maxsimmonds1337/EBIKE/KiCAD_Ebike_Controller/Download_STP_7461383_rev1.stp

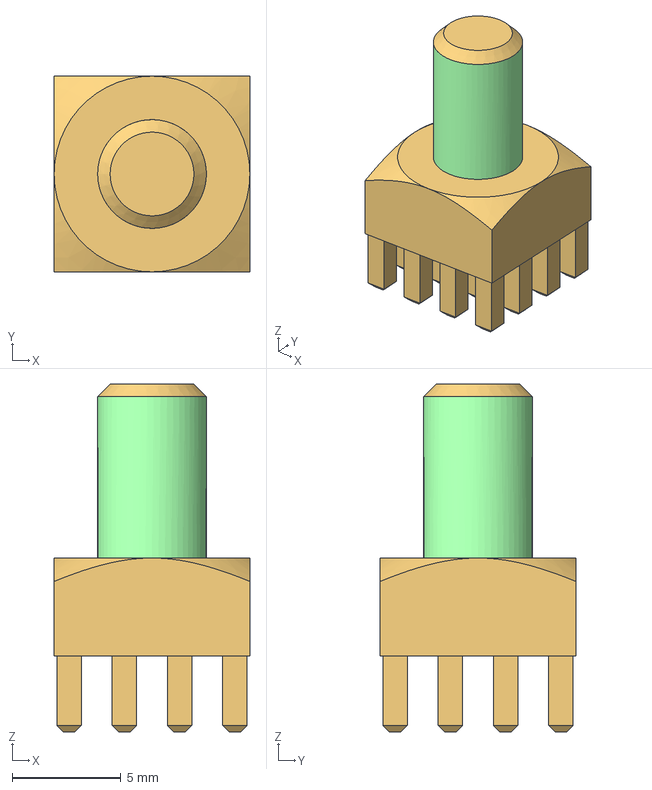
[picture p1: CAD file, 2021-01-02]
KiCAD_Ebike_Controller/Download_STP_7461383_rev1.stp
9.00 x 9.00 x 16.0 mm
