maxsimmonds1337/EBIKE/KiCAD_Ebike_Controller/Enclosure/box2.SLDPRT

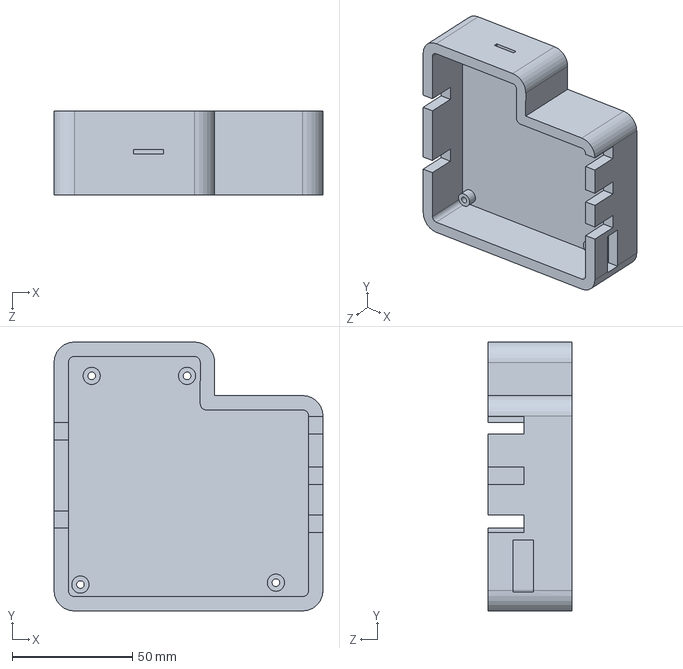
[picture p2: CAD file, 2021-09-16]
KiCAD_Ebike_Controller/Enclosure/box2.SLDPRT
112.0 x 112.0 x 35.0 mm
