maxsimmonds1337/EBIKE/KiCAD_Ebike_Controller/Enclosure/throttlebody.SLDPRT

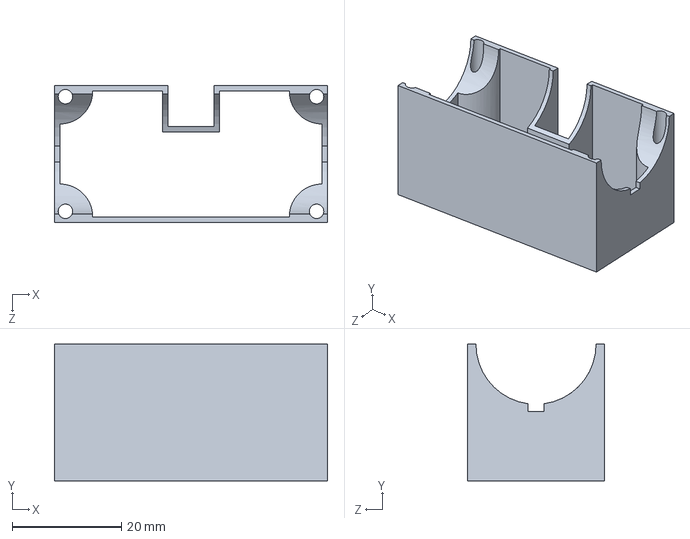
[picture p4: CAD file, 2021-09-16]
KiCAD_Ebike_Controller/Enclosure/throttlebody.SLDPRT
50.0 x 25.0 x 25.0 mm
