maxsimmonds1337/EBIKE/KiCAD_Ebike_Controller/Enclosure/throttlebodyTOP.SLDPRT

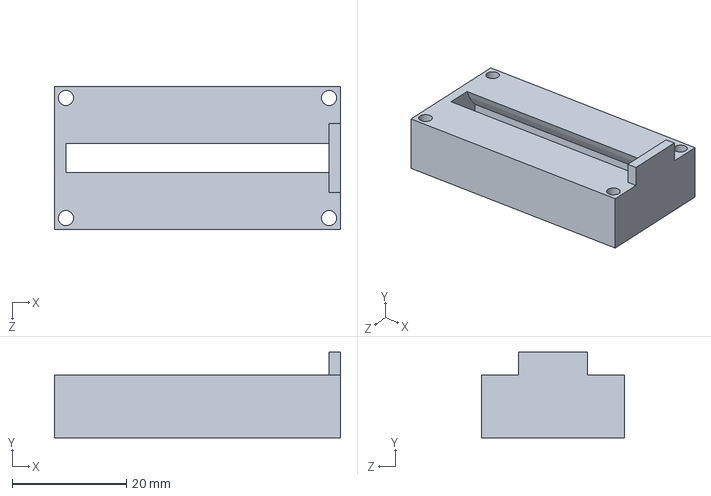
[picture p5: CAD file, 2021-09-16]
KiCAD_Ebike_Controller/Enclosure/throttlebodyTOP.SLDPRT
50.0 x 15.0 x 25.0 mm
