maxsimmonds1337/EBIKE/KiCAD_Ebike_Controller/Enclosure/SpeedoHolder.SLDPRT

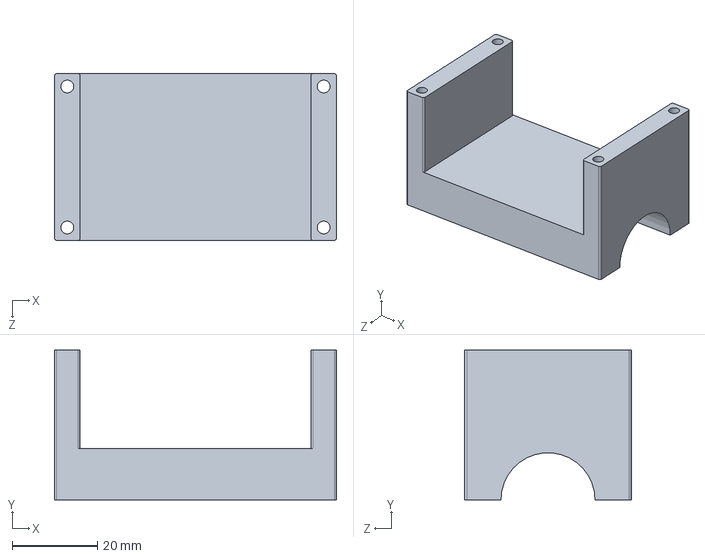
[picture p6: CAD file, 2021-09-16]
KiCAD_Ebike_Controller/Enclosure/SpeedoHolder.SLDPRT
66.0 x 35.0 x 39.0 mm
