maxsimmonds1337/EBIKE/KiCAD_Ebike_Controller/Enclosure/lid.SLDPRT

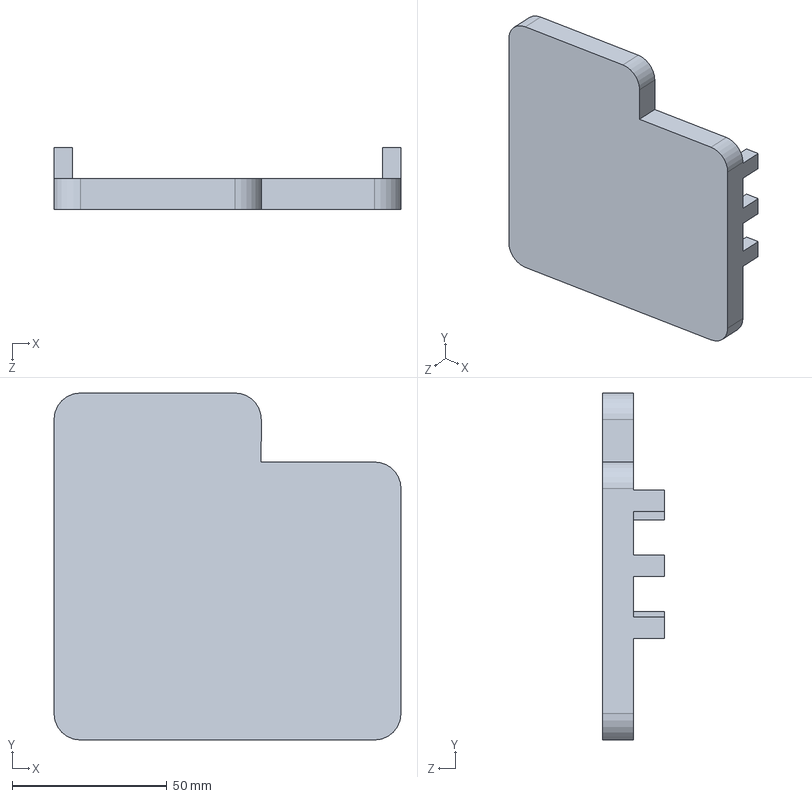
[picture p7: CAD file, 2021-09-16]
KiCAD_Ebike_Controller/Enclosure/lid.SLDPRT
112.0 x 112.0 x 20.0 mm
