maxsimmonds1337/EBIKE/(list of files, cad)

Other CAD files:
KiCAD_Ebike_Controller/Enclosure/SpeedoHolder.STL
KiCAD_Ebike_Controller/Enclosure/box.STL
KiCAD_Ebike_Controller/Enclosure/lid.STL
KiCAD_Ebike_Controller/Enclosure/throttlebody.STL
KiCAD_Ebike_Controller/Enclosure/throttlebodyTOP.STL
