maxsimmonds1337/EBIKE/(threads)

Thread 2 (2021-01-21):

C18 needs to be 470nF, not 0.47nF

maxsimmonds1337, 2021-01-21:
C18 needs to be 470nF, not 0.47nF - replace in the schematic. I have ordered a 470n instead.

Thread 10 (2021-02-06):

C30 Foot print wrong

maxsimmonds1337, 2021-02-06:
C30 Foot print wrong

Thread 12 (2021-02-06):

Low pass filter too long for hall effect

maxsimmonds1337, 2021-02-06:
Low pass filter too long for hall effect - change 100k to 23k (reuse buck resistor)

Thread 8 (2021-02-06):

D1-D6 footprint's too large

maxsimmonds1337, 2021-02-06:
D1-D6 footprint's too large

Thread 9 (2021-02-06):

U3 (I2C expander) footprint wrong

maxsimmonds1337, 2021-02-06:
U3 (I2C expander) footprint wrong

Thread 14 (2021-02-11):

I2C address

maxsimmonds1337, 2021-02-11:
address is 0x40 not 0x20, text needs changing on schematic

maxsimmonds1337, 2021-02-12:
This is actually correct, so closing

Closed 2021-02-12.

Thread 15 (2021-02-13):

Press fit connectors too large

maxsimmonds1337, 2021-02-13:
The press fit connectors do not press in to the connectors, upon review, it seems the hole diameter should be 1.45mm, currently it is 1.6mm.

Thread 16 (2021-02-19):

Swap pwm and direction lines

maxsimmonds1337, 2021-02-19:
Swap pwm and direction lines, this is because the io for the pwm does not have a timer output channel needed for the pwm.

Thread 17 (2021-02-20):

wrong resistor for buck converter

maxsimmonds1337, 2021-02-20:
swap the 23.7K resistor for a 16.2k
