maxsimmonds1337/EBIKE/KiCAD_Ebike_Controller/Ebike_Controller.pdf

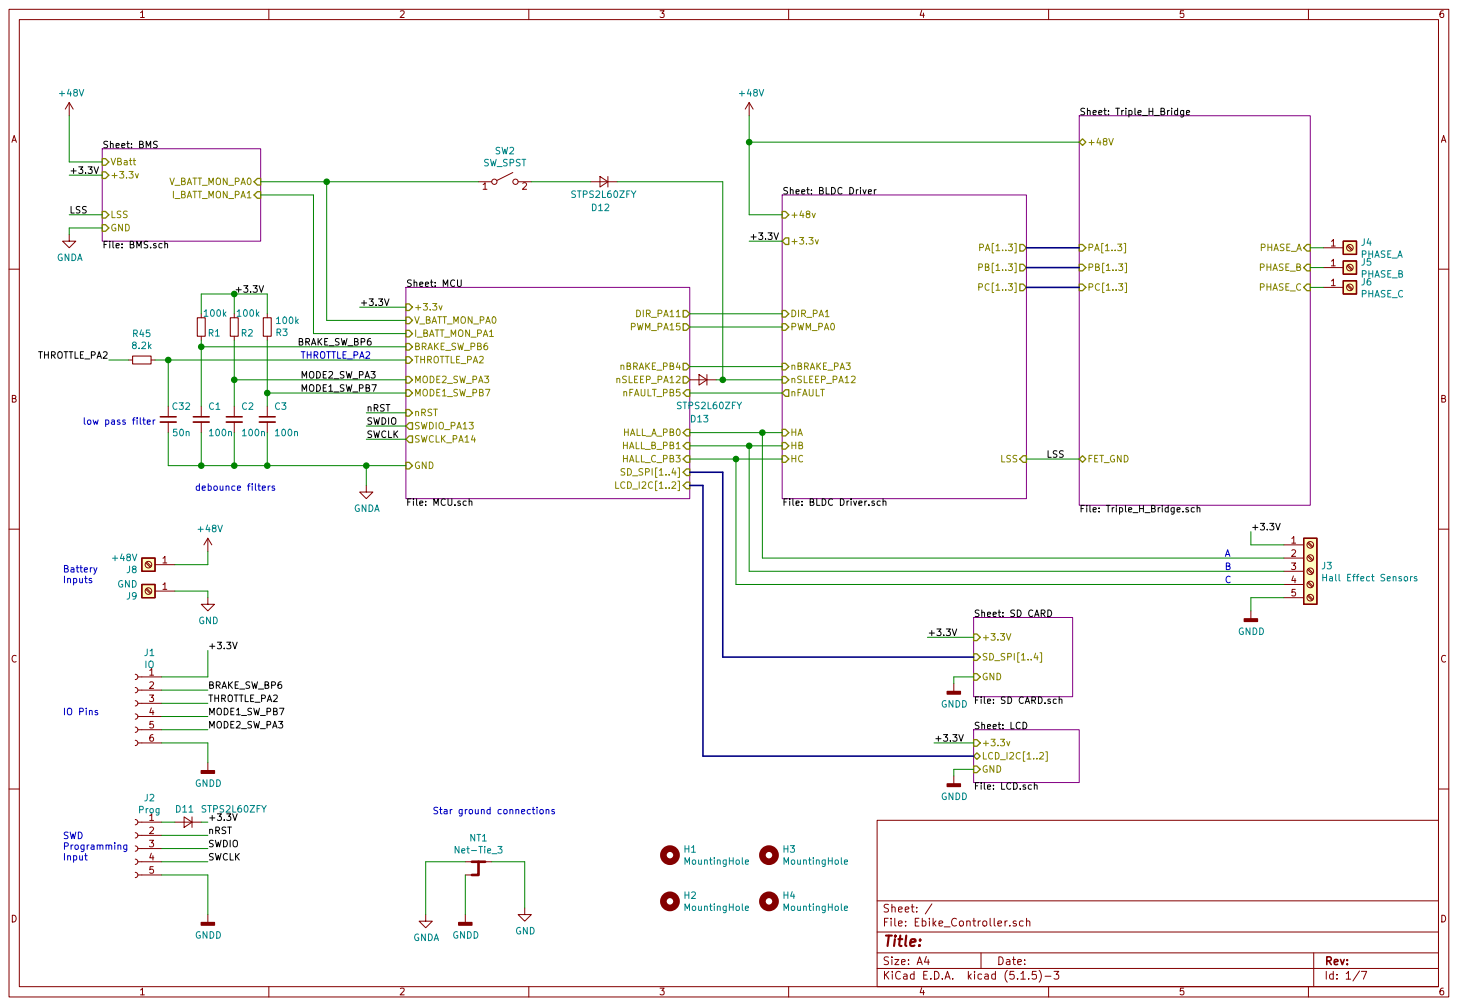
[picture p8: page 1]

PC[1..3] Sheet: BLDC Driver File: BLDC Driver.sch HC

File: SD CARD.sch GND

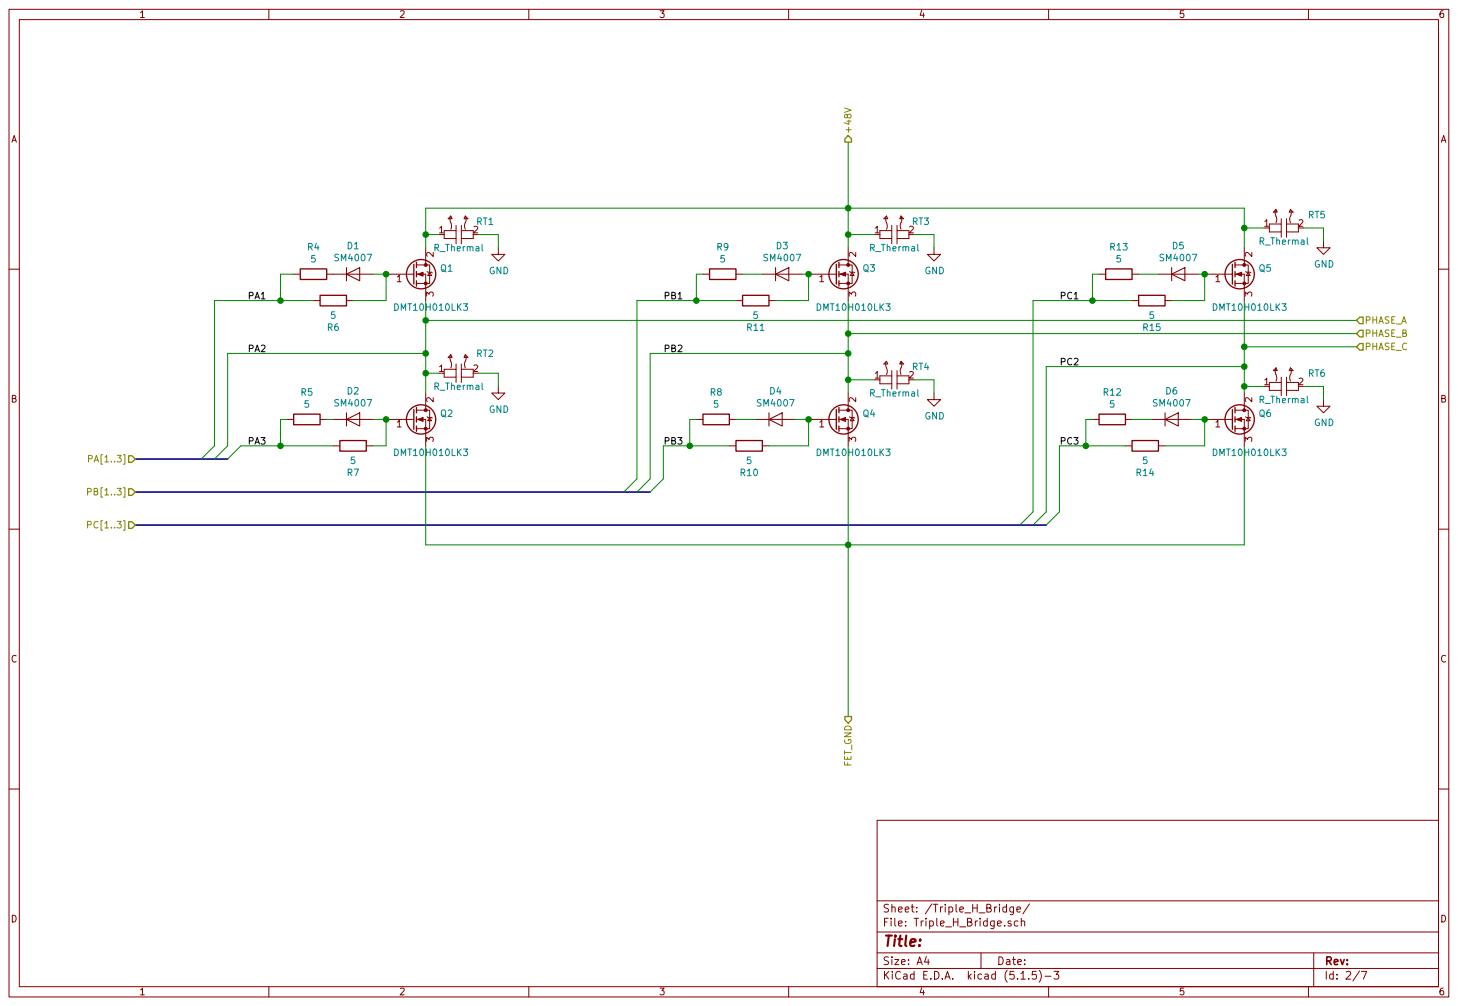
[picture p9: page 2]

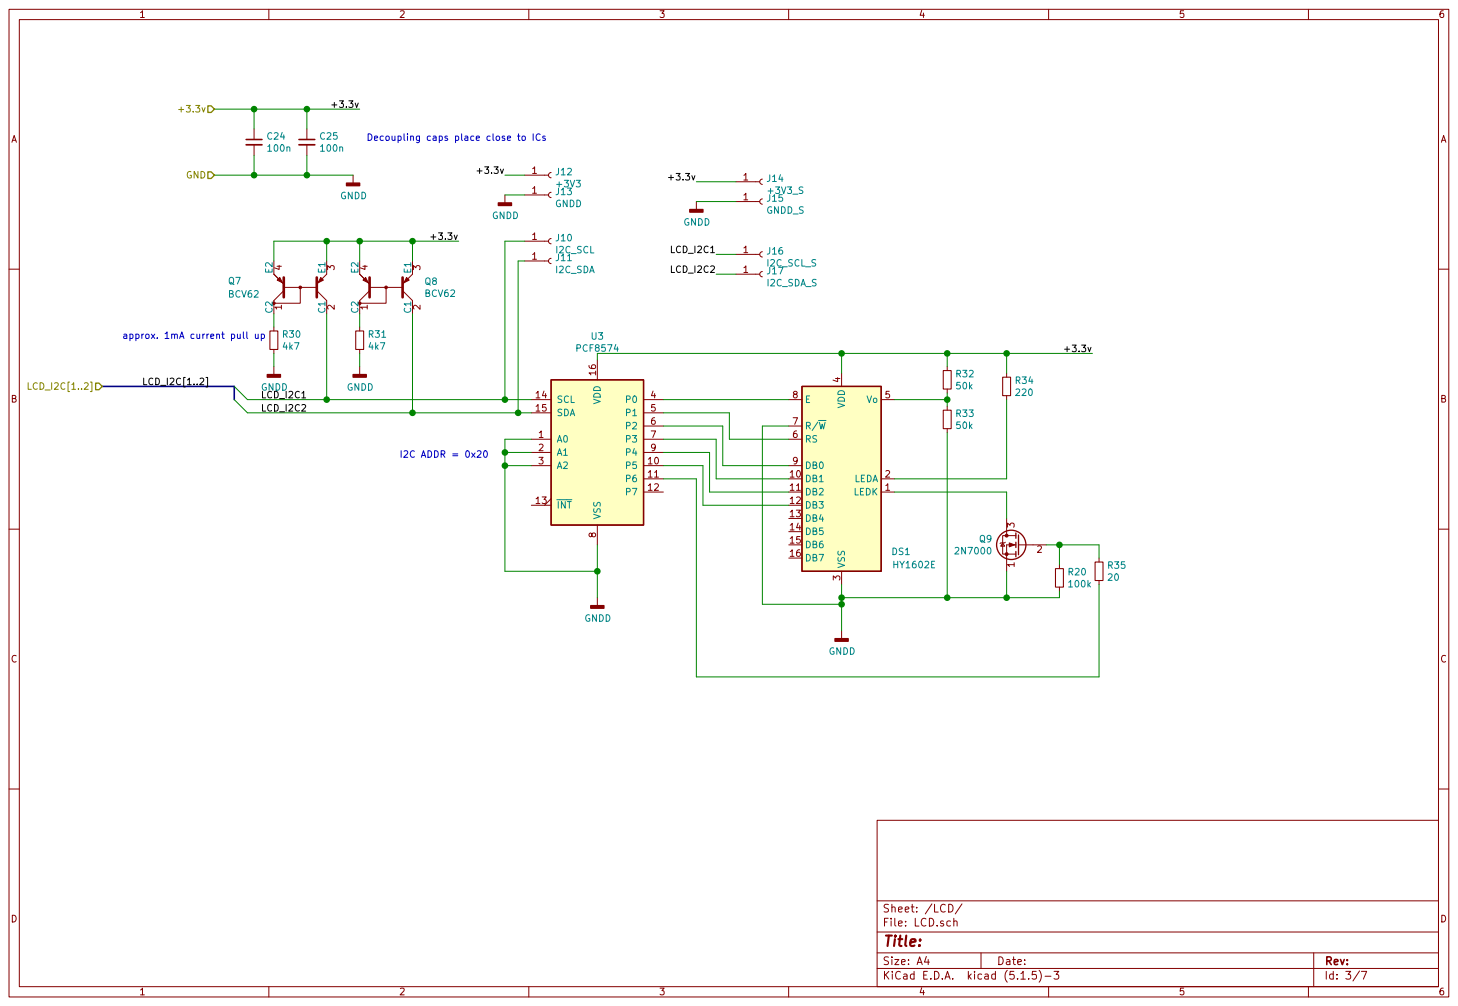
[picture p10: page 3]

I2C ADDR = 0x20 Decoupling caps place close to ICs

approx. 1mA current pull up

Id: 3/7 Title: File: LCD.sch Sheet: /LCD/

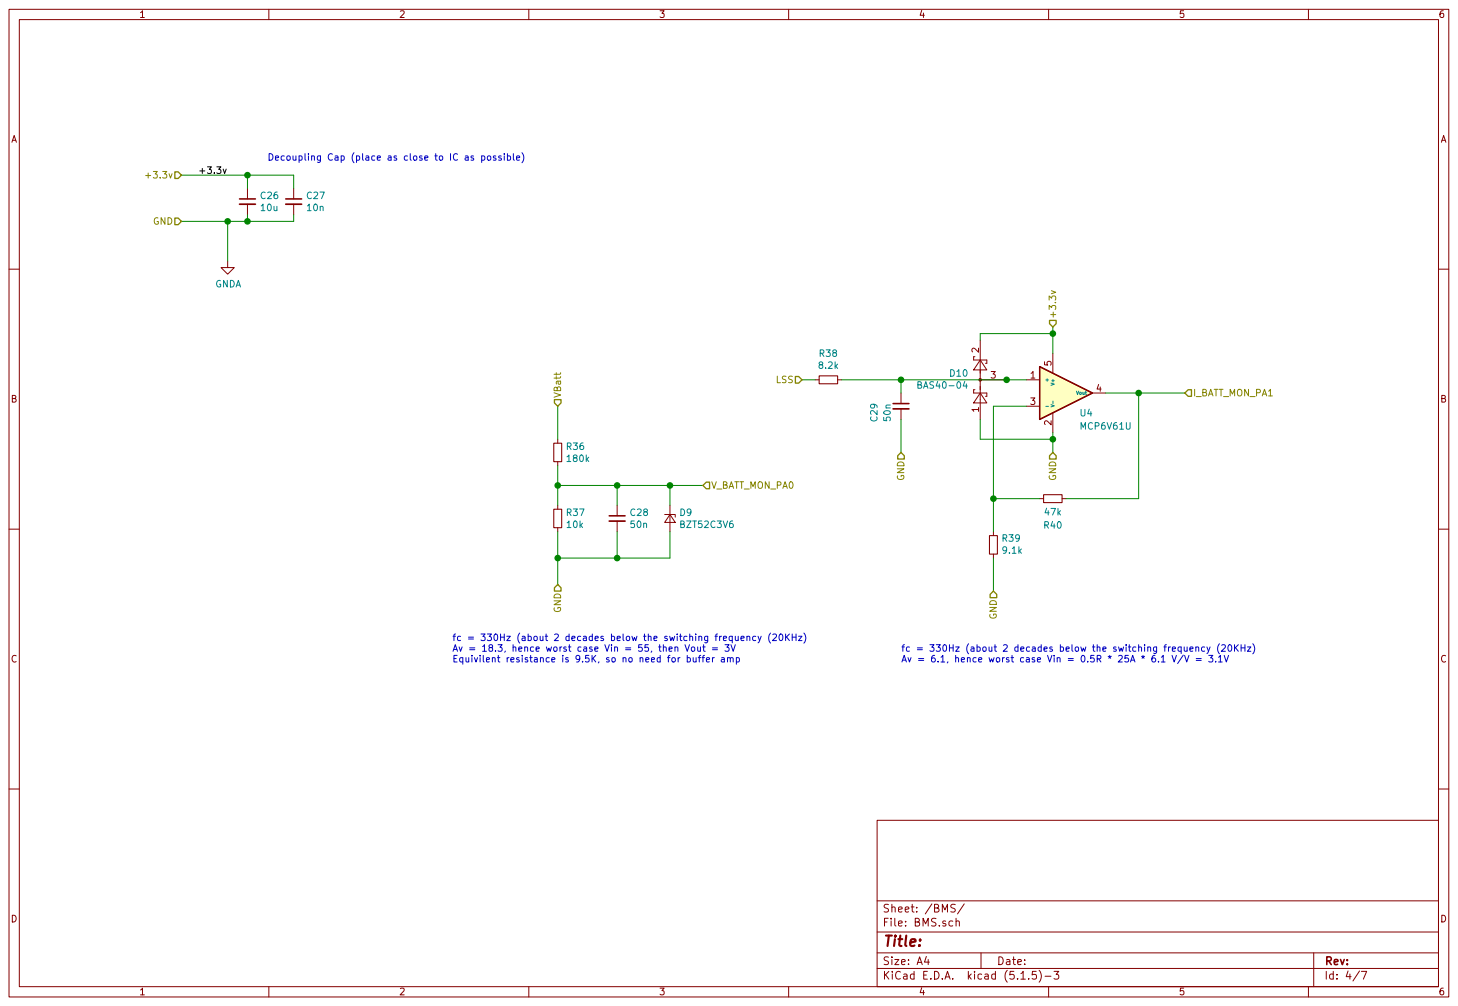
[picture p11: page 4]

Decoupling Cap (place as close to IC as possible)

Id: 4/7 Title: File: BMS.sch Sheet: /BMS/ C29 50n D9BZT52C3V6 GNDA

fc = 330Hz (about 2 decades below the switching frequency (20KHz) Av = 18.3, hence worst case Vin = 55, then Vout = 3V

fc = 330Hz (about 2 decades below the switching frequency (20KHz) Av = 6.1, hence worst case Vin = 0.5R * 25A * 6.1 V/V = 3.1V

Equivilent resistance is 9.5K, so no need for buffer amp

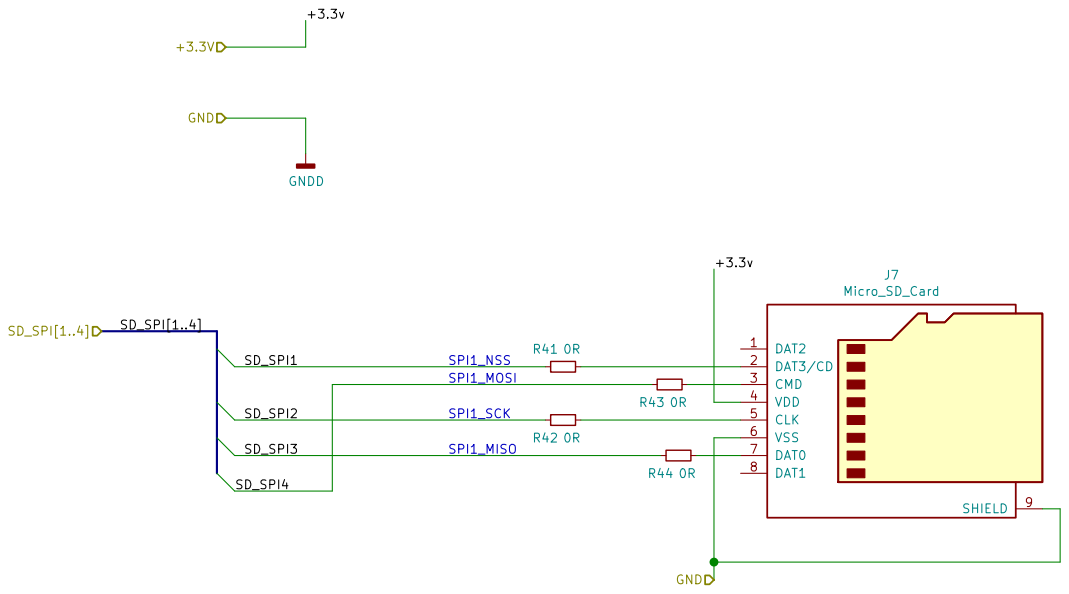
[picture p12: page 5]

Id: 5/7 Title: File: SD CARD.sch Sheet: /SD CARD/

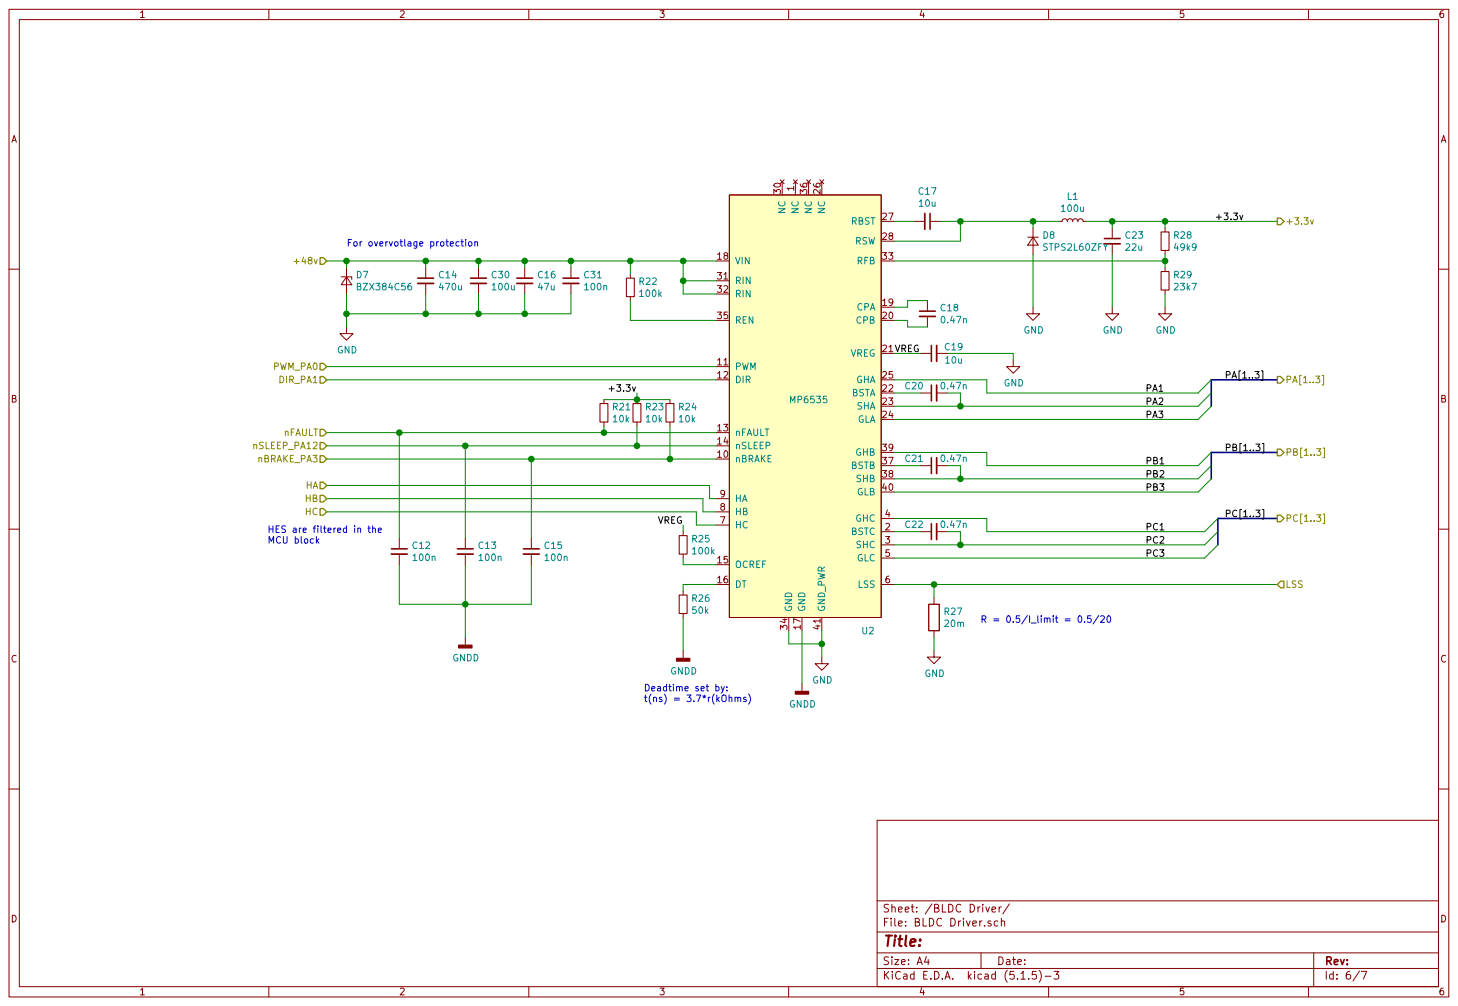
[picture p13: page 6]

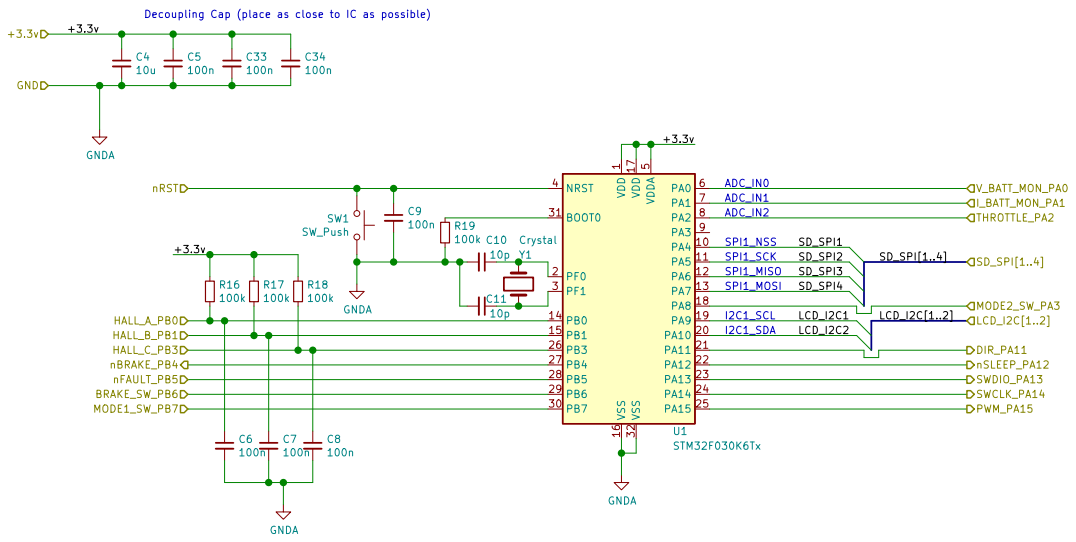
[picture p14: page 7]

ADC_IN0 Decoupling Cap (place as close to IC as possible)

Id: 7/7 Title: File: MCU.sch Sheet: /MCU/ C8
