maxsimmonds1337/EBIKE/KiCAD_Ebike_Controller/Ebike_Controller.kicad_pcb

## KiCad design KiCAD_Ebike_Controller/Ebike_Controller.kicad_pcb (2021-09-16)

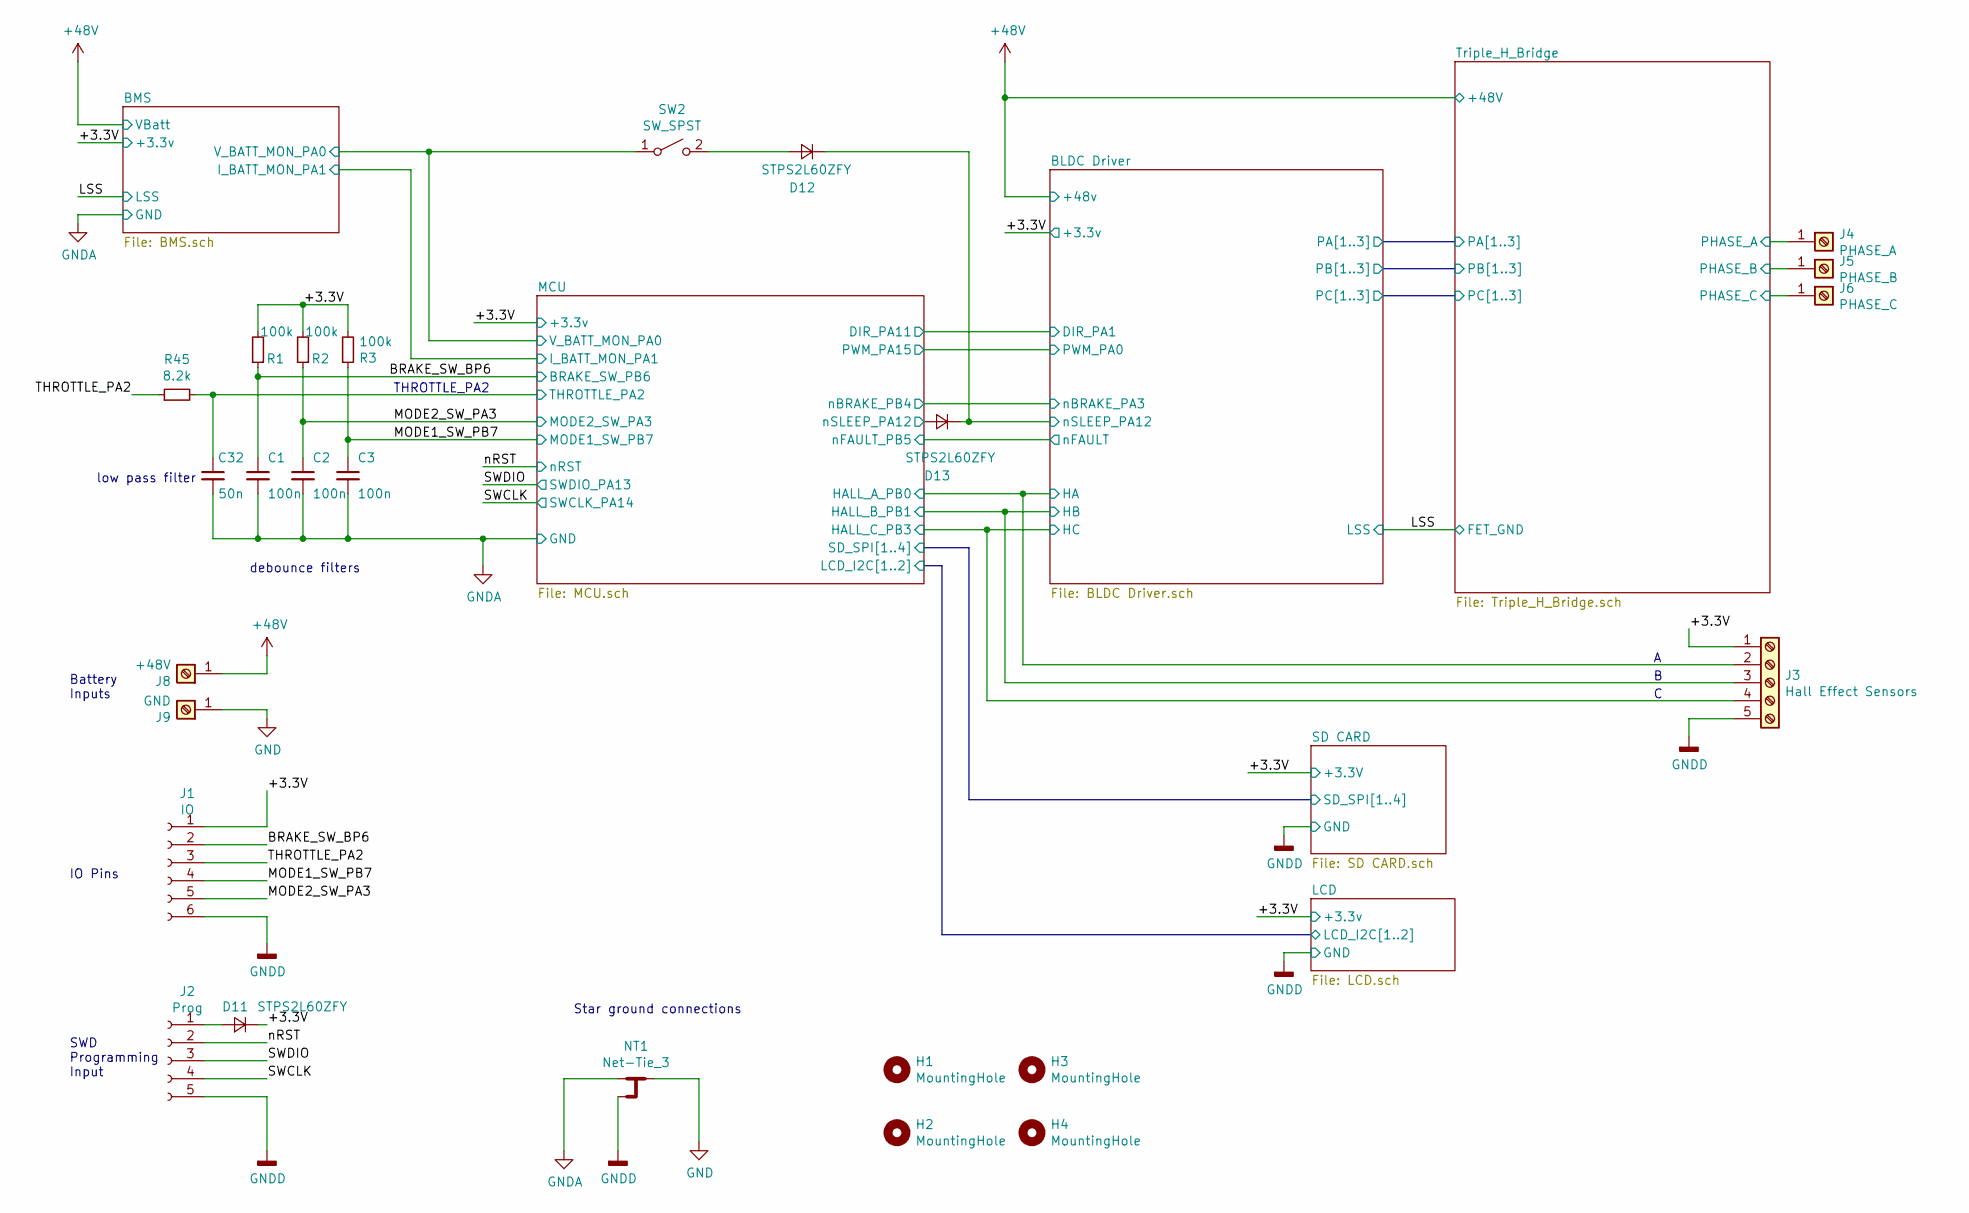
[picture p15: schematic Ebike_Controller.sch]

Parts:
C1, C2, C3: 100n; C_0805_2012Metric_Pad1.15x1.40mm_HandSolder
C32: 50n; C_0805_2012Metric_Pad1.15x1.40mm_HandSolder
D11, D12, D13: STPS2L60ZFY; D_SOD-123
H1, H2: MountingHole; MountingHole_3.2mm_M3
H3, H4: MountingHole; MountingHole_3.2mm_M3_DIN965
J1: IO; PinHeader_1x06_P2.54mm_Vertical
J2: Prog; PinHeader_1x05_P2.54mm_Vertical
J3: Hall Effect Sensors; PhoenixContact_MC_1,5_5-G-3.81_1x05_P3.81mm_Horizontal
J4: PHASE_A; 180A_screw_terminal_7461383
J5: PHASE_B; 180A_screw_terminal_7461383
J6: PHASE_C; 180A_screw_terminal_7461383
J8: +48V; 180A_screw_terminal_7461383
J9: GND; 180A_screw_terminal_7461383
NT1: Net-Tie_3; NetTie-3_THT_Pad1.0mm
R1, R2, R3: 100k; R_0805_2012Metric_Pad1.15x1.40mm_HandSolder
R45: 8.2k; R_0805_2012Metric_Pad1.15x1.40mm_HandSolder
SW2: SW_SPST; PinHeader_1x02_P2.54mm_Vertical

Connections:
+48V: J8.1; also elsewhere on the board
/+3.3V: D11.1 (K), J1.1, J3.1, R1.2, R2.2, R3.2; also elsewhere on the board
/BLDC Driver/HA: J3.2; also elsewhere on the board
/BLDC Driver/nSLEEP_PA12: D12.1 (K), D13.1 (K); also elsewhere on the board
/BMS/V_BATT_MON_PA0: SW2.1 (A); also elsewhere on the board
/BRAKE_SW_BP6: C1.1, J1.2, R1.1; also elsewhere on the board
/MCU/HALL_B_PB1: J3.3; also elsewhere on the board
/MCU/HALL_C_PB3: J3.4; also elsewhere on the board
/MCU/THROTTLE_PA2: C32.1, R45.2; also elsewhere on the board
/MCU/nSLEEP_PA12: D13.2 (A); also elsewhere on the board
/MODE1_SW_PB7: C3.1, J1.4, R3.1; also elsewhere on the board
/MODE2_SW_PA3: C2.1, J1.5, R2.1; also elsewhere on the board
/SWCLK: J2.4; also elsewhere on the board
/SWDIO: J2.3; also elsewhere on the board
/THROTTLE_PA2: J1.3, R45.1
/Triple_H_Bridge/PHASE_A: J4.1; also elsewhere on the board
/Triple_H_Bridge/PHASE_B: J5.1; also elsewhere on the board
/Triple_H_Bridge/PHASE_C: J6.1; also elsewhere on the board
/nRST: J2.2; also elsewhere on the board
GND: J9.1, NT1.2; also elsewhere on the board
GNDA: C1.2, C2.2, C3.2, C32.2, NT1.1; also elsewhere on the board
GNDD: J1.6, J2.5, J3.5, NT1.3; also elsewhere on the board
unnamed: D11.2 (A), J2.1
unnamed: D12.2 (A), SW2.2 (B)

Notes on the sheet:
SWD Programming Input
debounce filters
IO Pins
Battery Inputs
THROTTLE_PA2
low pass filter
Star ground connections

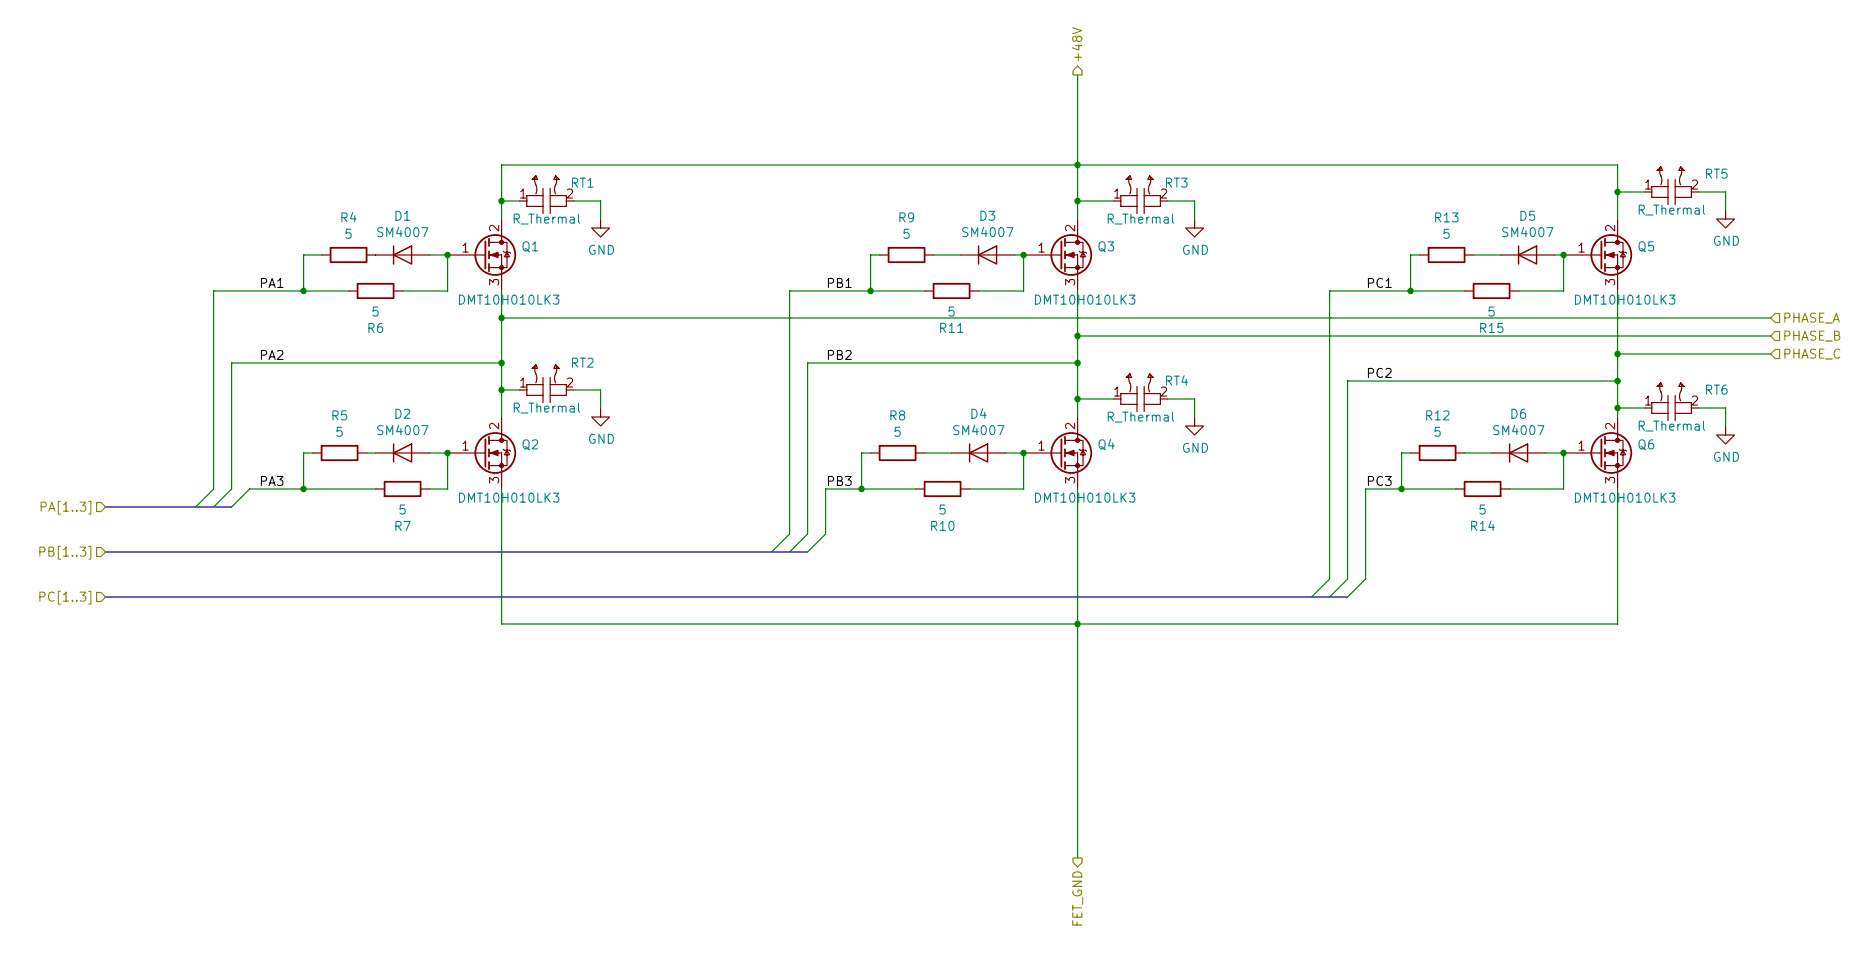
[picture p16: schematic Triple_H_Bridge.sch]

Parts:
D1, D2, D3, D4, D5, D6: SM4007; D_MELF
Q1, Q2, Q3, Q4, Q5, Q6: DMT10H010LK3; TO-252-3_TabPin2
R4, R5, R6, R7, R8, R9, R10, R11, R12, R13, R14, R15: 5; R_0805_2012Metric_Pad1.15x1.40mm_HandSolder
RT1, RT2, RT3, RT4, RT5, RT6: R_Thermal; R_1206_3216Metric_Pad1.42x1.75mm_HandSolder

Connections:
+48V: Q1.2 (D), Q3.2 (D), Q5.2 (D), RT1.1, RT3.1, RT5.1; also elsewhere on the board
/BLDC Driver/PA1: R4.2, R6.2; also elsewhere on the board
/BLDC Driver/PA3: R5.2, R7.2; also elsewhere on the board
/BLDC Driver/PB1: R9.2, R11.2; also elsewhere on the board
/BLDC Driver/PB3: R8.2, R10.2; also elsewhere on the board
/BLDC Driver/PC1: R13.2, R15.2; also elsewhere on the board
/BLDC Driver/PC3: R12.2, R14.1; also elsewhere on the board
/LSS: Q2.3 (S), Q4.3 (S), Q6.3 (S); also elsewhere on the board
/Triple_H_Bridge/PHASE_A: Q1.3 (S), Q2.2 (D), RT2.1; also elsewhere on the board
/Triple_H_Bridge/PHASE_B: Q3.3 (S), Q4.2 (D), RT4.1; also elsewhere on the board
/Triple_H_Bridge/PHASE_C: Q5.3 (S), Q6.2 (D), RT6.1; also elsewhere on the board
GND: RT1.2, RT2.2, RT3.2, RT4.2, RT5.2, RT6.2; also elsewhere on the board
unnamed: D1.1 (K), R4.1
unnamed: D1.2 (A), Q1.1 (G), R6.1
unnamed: D2.1 (K), R5.1
unnamed: D2.2 (A), Q2.1 (G), R7.1
unnamed: D3.1 (K), R9.1
unnamed: D3.2 (A), Q3.1 (G), R11.1
unnamed: D4.1 (K), R8.1
unnamed: D4.2 (A), Q4.1 (G), R10.1
unnamed: D5.1 (K), R13.1
unnamed: D5.2 (A), Q5.1 (G), R15.1
unnamed: D6.1 (K), R12.1
unnamed: D6.2 (A), Q6.1 (G), R14.2

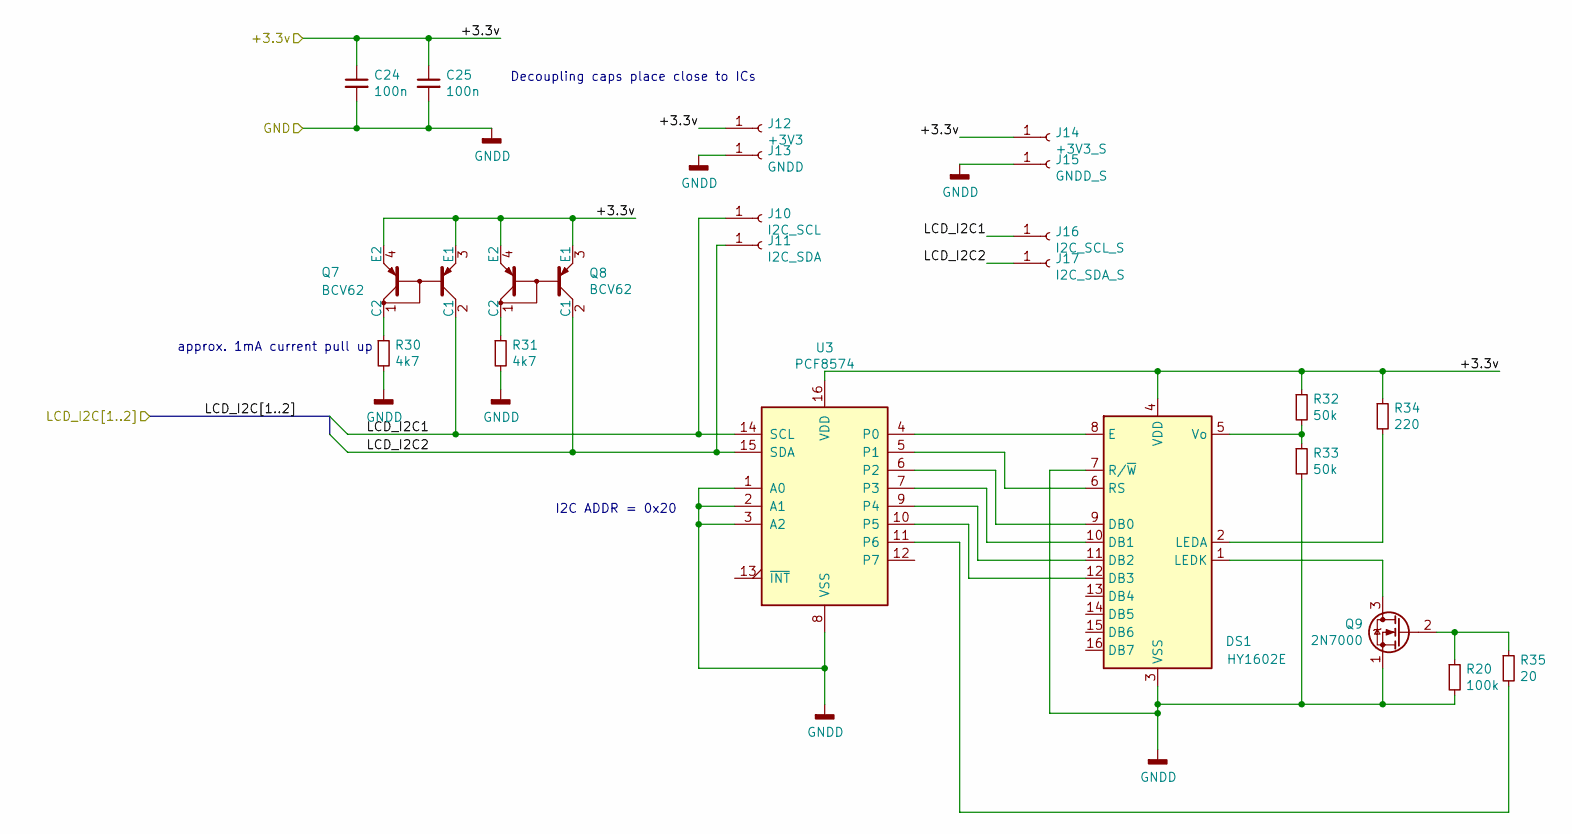
[picture p17: schematic LCD.sch]

Parts:
C24, C25: 100n; C_0805_2012Metric_Pad1.15x1.40mm_HandSolder
DS1: HY1602E
J10: I2C_SCL; PinHeader_1x01_P2.54mm_Vertical
J11: I2C_SDA; PinHeader_1x01_P2.54mm_Vertical
J12: +3V3; PinHeader_1x01_P2.54mm_Vertical
J13: GNDD; PinHeader_1x01_P2.54mm_Vertical
J14: +3V3_S; PinHeader_1x01_P2.54mm_Vertical
J15: GNDD_S; PinHeader_1x01_P2.54mm_Vertical
J16: I2C_SCL_S; PinHeader_1x01_P2.54mm_Vertical
J17: I2C_SDA_S; PinHeader_1x01_P2.54mm_Vertical
Q7, Q8: BCV62; SOT-143
Q9: 2N7000; TO-92_Inline
R20: 100k; R_0805_2012Metric_Pad1.15x1.40mm_HandSolder
R30, R31: 4k7; R_0805_2012Metric_Pad1.15x1.40mm_HandSolder
R32, R33: 50k; R_0805_2012Metric_Pad1.15x1.40mm_HandSolder
R34: 220; R_0805_2012Metric_Pad1.15x1.40mm_HandSolder
R35: 20; R_0805_2012Metric_Pad1.15x1.40mm_HandSolder
U3: PCF8574; SOIC-18W_7.5x11.6mm_P1.27mm

Connections:
/+3.3V: C24.1, C25.1, DS1.4 (VDD), J12.1, J14.1, Q7.3 (E1), Q7.4 (E2), Q8.3 (E1), Q8.4 (E2), R32.1, R34.1, U3.16 (VDD); also elsewhere on the board
/LCD/LCD_I2C1: J10.1, J16.1, Q7.2 (C1), U3.14 (SCL); also elsewhere on the board
/LCD/LCD_I2C2: J11.1, J17.1, Q8.2 (C1), U3.15 (SDA); also elsewhere on the board
GNDD: C24.2, C25.2, DS1.3 (VSS), DS1.7 (R/~W), J13.1, J15.1, Q9.1 (S), R20.2, R30.2, R31.2, R33.2, U3.1 (A0), U3.2 (A1), U3.3 (A2), U3.8 (VSS); also elsewhere on the board
unnamed: DS1.1 (LEDK), Q9.3 (D)
unnamed: DS1.2 (LEDA), R34.2
unnamed: DS1.5 (Vo), R32.2, R33.1
unnamed: DS1.6 (RS), U3.5 (P1)
unnamed: DS1.8 (E), U3.4 (P0)
unnamed: DS1.9 (DB0), U3.6 (P2)
unnamed: DS1.10 (DB1), U3.7 (P3)
unnamed: DS1.11 (DB2), U3.9 (P4)
unnamed: DS1.12 (DB3), U3.10 (P5)
unnamed: Q7.1 (C2), R30.1
unnamed: Q8.1 (C2), R31.1
unnamed: Q9.2 (G), R20.1, R35.1
unnamed: R35.2, U3.11 (P6)

Notes on the sheet:
I2C ADDR = 0x20
Decoupling caps place close to ICs
approx. 1mA current pull up

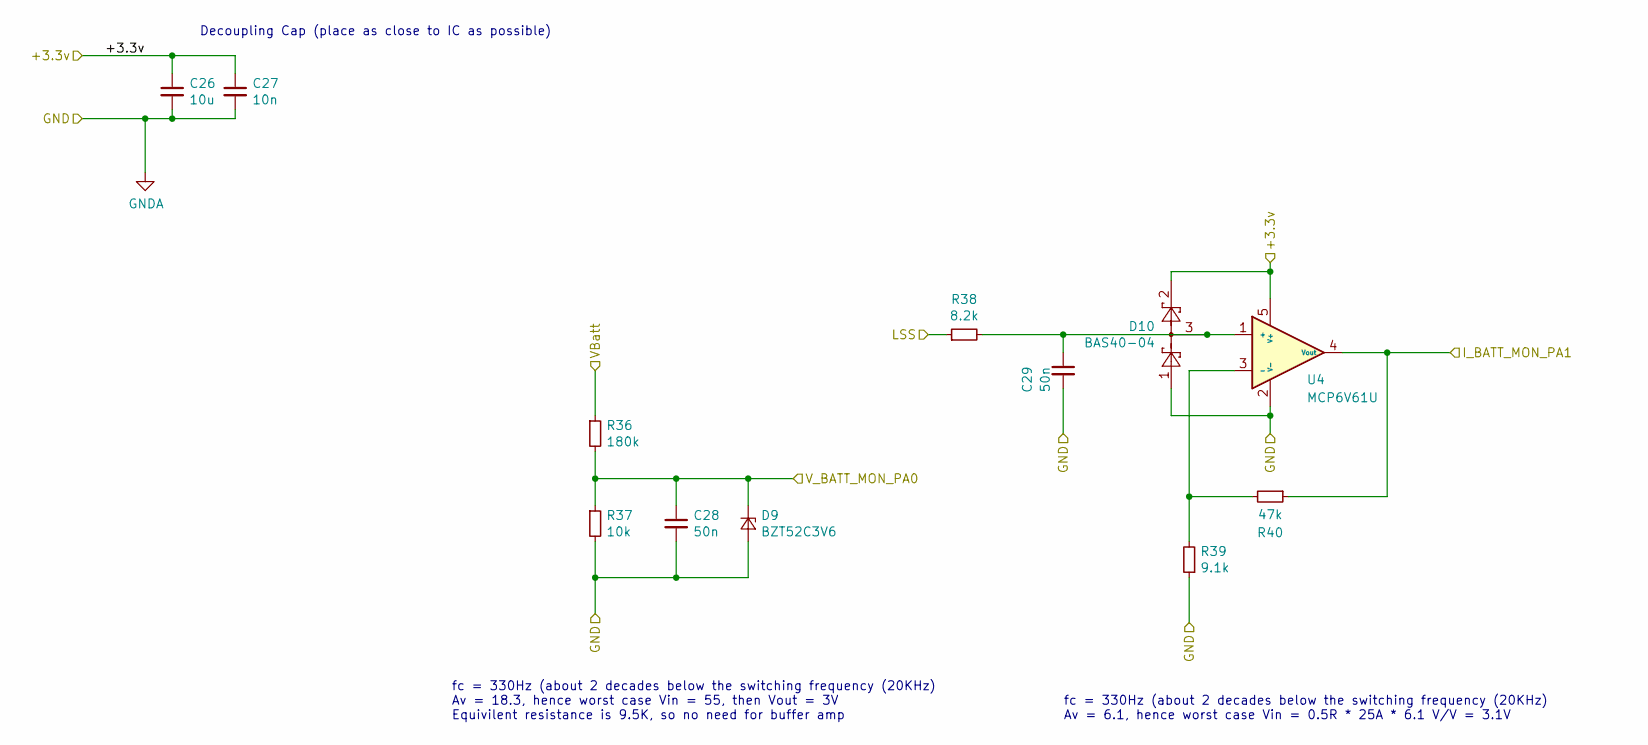
[picture p18: schematic BMS.sch]

Parts:
C26: 10u; C_0805_2012Metric
C27: 10n; C_0805_2012Metric
C28, C29: 50n; C_0805_2012Metric_Pad1.15x1.40mm_HandSolder
D9: BZT52C3V6; D_SOD-123
D10: BAS40-04; SOT-23
R36: 180k; R_0805_2012Metric_Pad1.15x1.40mm_HandSolder
R37: 10k; R_0805_2012Metric_Pad1.15x1.40mm_HandSolder
R38: 8.2k; R_0805_2012Metric_Pad1.15x1.40mm_HandSolder
R39: 9.1k; R_0805_2012Metric_Pad1.15x1.40mm_HandSolder
R40: 47k; R_0805_2012Metric_Pad1.15x1.40mm_HandSolder
U4: MCP6V61U; SOT-353_SC-70-5_Handsoldering

Connections:
+48V: R36.1; also elsewhere on the board
/+3.3V: C26.1, C27.1, D10.2, U4.5 (V+); also elsewhere on the board
/BMS/I_BATT_MON_PA1: R40.1, U4.4 (Vout); also elsewhere on the board
/BMS/V_BATT_MON_PA0: C28.1, D9.1 (K), R36.2, R37.1; also elsewhere on the board
/LSS: R38.1; also elsewhere on the board
GNDA: C26.2, C27.2, C28.2, C29.2, D9.2 (A), D10.1, R37.2, R39.1, U4.2 (V-); also elsewhere on the board
unnamed: C29.1, D10.3, R38.2, U4.1 (+)
unnamed: R39.2, R40.2, U4.3 (-)

Notes on the sheet:
fc = 330Hz (about 2 decades below the switching frequency (20KHz) Av = 6.1, hence worst case Vin = 0.5R * 25A * 6.1 V/V = 3.1V
fc = 330Hz (about 2 decades below the switching frequency (20KHz) Av = 18.3, hence worst case Vin = 55, then Vout = 3V Equivilent resistance is 9.5K, so no need for buffer amp
Decoupling Cap (place as close to IC as possible)

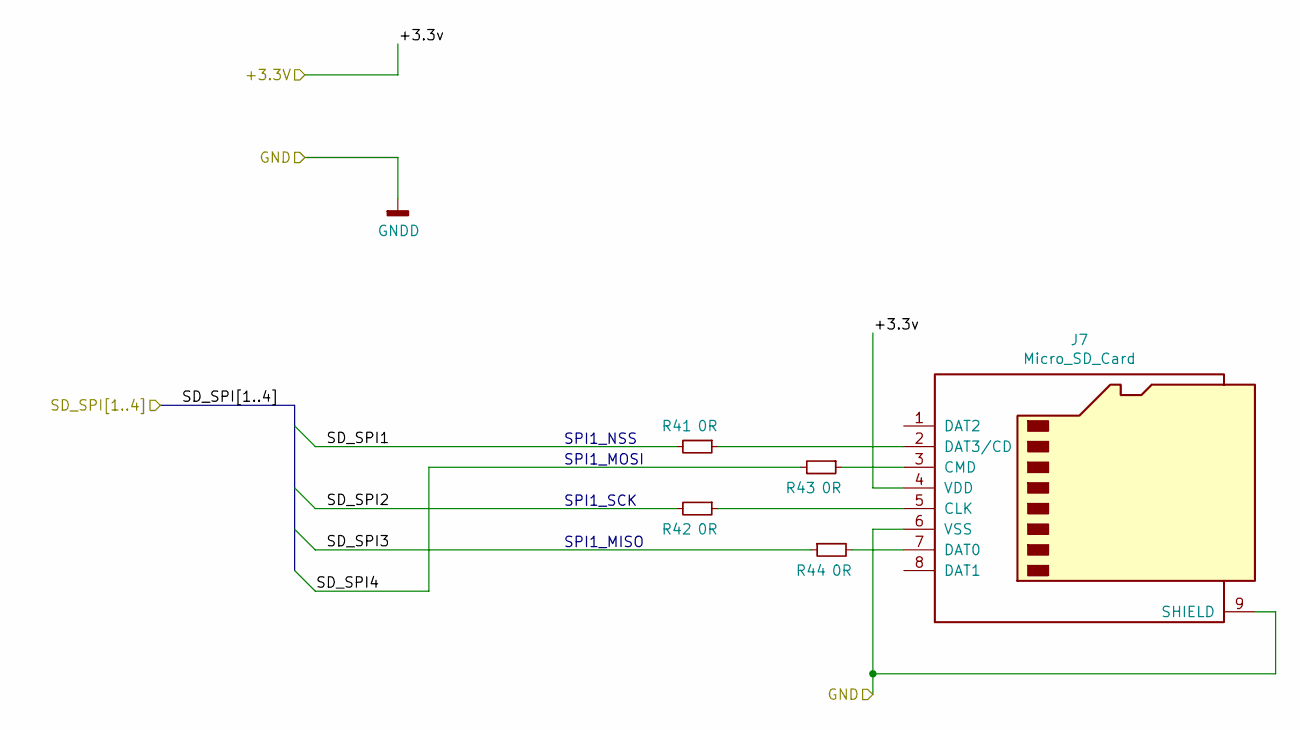
[picture p19: schematic SD CARD.sch]

Parts:
J7: Micro_SD_Card; microSD_HC_Hirose_DM3D-SF
R41, R42, R43, R44: 0R; R_0805_2012Metric_Pad1.15x1.40mm_HandSolder

Connections:
/+3.3V: J7.4 (VDD); also elsewhere on the board
/MCU/SD_SPI1: R41.2; also elsewhere on the board
/MCU/SD_SPI2: R42.2; also elsewhere on the board
/MCU/SD_SPI3: R44.1; also elsewhere on the board
/MCU/SD_SPI4: R43.2; also elsewhere on the board
GNDD: J7.6 (VSS), J7.9 (SHIELD); also elsewhere on the board
unnamed: J7.2 (DAT3/CD), R41.1
unnamed: J7.3 (CMD), R43.1
unnamed: J7.5 (CLK), R42.1
unnamed: J7.7 (DAT0), R44.2

Notes on the sheet:
SPI1_NSS
SPI1_SCK
SPI1_MISO
SPI1_MOSI

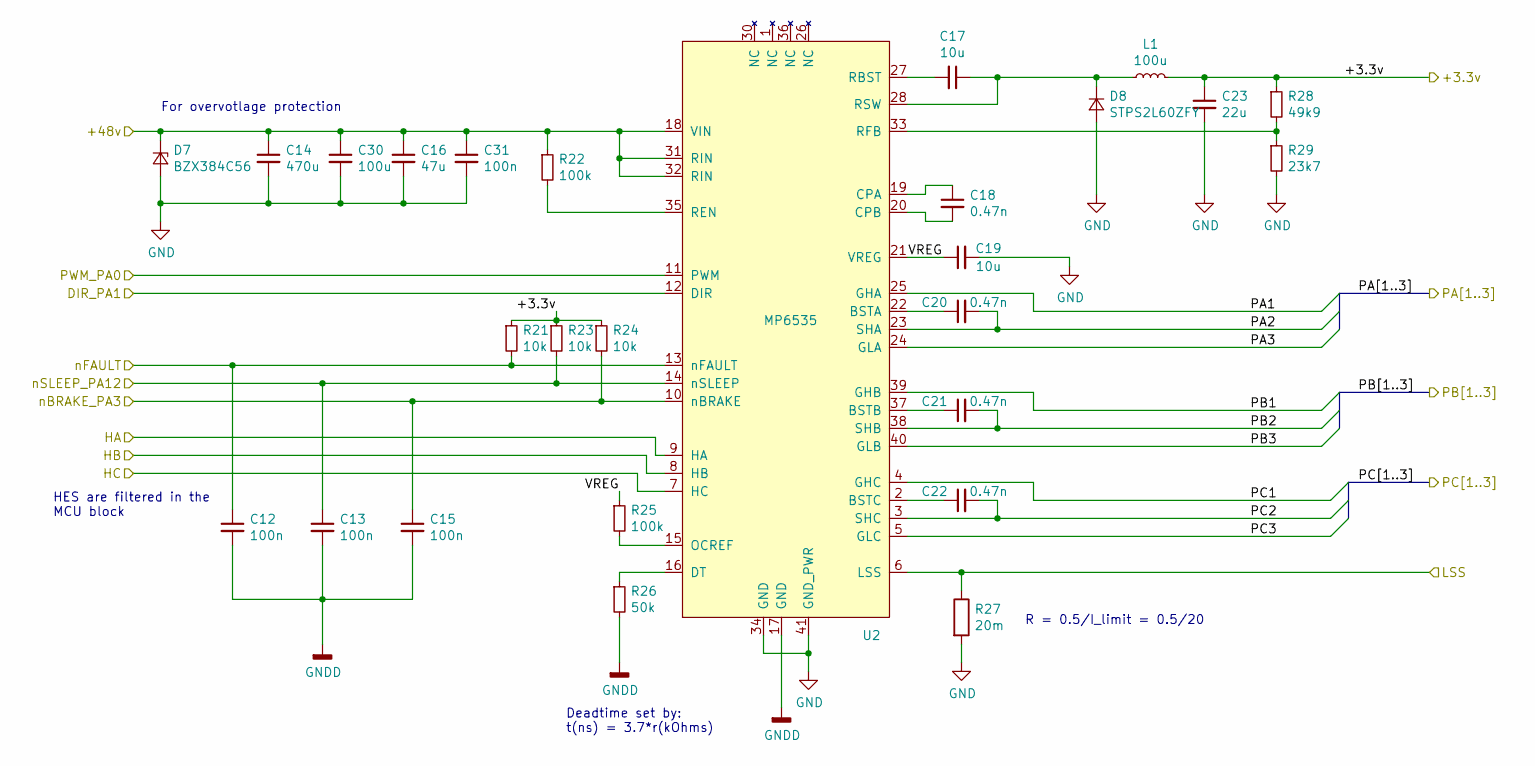
[picture p20: schematic BLDC Driver.sch]

Parts:
C12, C13, C15, C31: 100n; C_0805_2012Metric_Pad1.15x1.40mm_HandSolder
C14: 470u; CP_Elec_16x17.5
C16: 47u; CP_Elec_8x10
C17, C19: 10u; C_0805_2012Metric_Pad1.15x1.40mm_HandSolder
C18, C20, C21, C22: 0.47n; C_0805_2012Metric_Pad1.15x1.40mm_HandSolder
C23: 22u; C_0805_2012Metric_Pad1.15x1.40mm_HandSolder
C30: 100u; CP_Elec_16x17.5
D7: BZX384C56; D_SOD-323
D8: STPS2L60ZFY; D_SOD-123
L1: 100u; L_10.4x10.4_H4.8
R21, R23, R24: 10k; R_0805_2012Metric_Pad1.15x1.40mm_HandSolder
R22, R25: 100k; R_0805_2012Metric_Pad1.15x1.40mm_HandSolder
R26: 50k; R_0805_2012Metric_Pad1.15x1.40mm_HandSolder
R27: 20m; 20m_4W
R28: 49k9; R_0805_2012Metric_Pad1.15x1.40mm_HandSolder
R29: 23k7; R_0805_2012Metric_Pad1.15x1.40mm_HandSolder
U2: MP6535; QFN-40-1EP_5x5mm_P0.4mm_EP3.6x3.6mm

Connections:
+48V: C14.1, C16.1, C30.1, C31.1, D7.1 (K), R22.1, U2.18 (VIN), U2.31 (RIN), U2.32 (RIN); also elsewhere on the board
/+3.3V: C23.1, L1.2, R21.1, R23.1, R24.1, R28.1; also elsewhere on the board
/BLDC Driver/DIR_PA1: U2.12 (DIR); also elsewhere on the board
/BLDC Driver/HA: U2.9 (HA); also elsewhere on the board
/BLDC Driver/PA1: U2.25 (GHA); also elsewhere on the board
/BLDC Driver/PA3: U2.24 (GLA); also elsewhere on the board
/BLDC Driver/PB1: U2.39 (GHB); also elsewhere on the board
/BLDC Driver/PB3: U2.40 (GLB); also elsewhere on the board
/BLDC Driver/PC1: U2.4 (GHC); also elsewhere on the board
/BLDC Driver/PC3: U2.5 (GLC); also elsewhere on the board
/BLDC Driver/PWM_PA0: U2.11 (PWM); also elsewhere on the board
/BLDC Driver/VREG: C19.1, R25.1, U2.21 (VREG)
/BLDC Driver/nBRAKE_PA3: C15.1, R24.2, U2.10 (nBRAKE); also elsewhere on the board
/BLDC Driver/nFAULT: C12.1, R21.2, U2.13 (nFAULT); also elsewhere on the board
/BLDC Driver/nSLEEP_PA12: C13.1, R23.2, U2.14 (nSLEEP); also elsewhere on the board
/LSS: R27.1, U2.6 (LSS); also elsewhere on the board
/MCU/HALL_B_PB1: U2.8 (HB); also elsewhere on the board
/MCU/HALL_C_PB3: U2.7 (HC); also elsewhere on the board
/Triple_H_Bridge/PHASE_A: C20.2, U2.23 (SHA); also elsewhere on the board
/Triple_H_Bridge/PHASE_B: C21.2, U2.38 (SHB); also elsewhere on the board
/Triple_H_Bridge/PHASE_C: C22.2, U2.3 (SHC); also elsewhere on the board
GND: C14.2, C16.2, C19.2, C23.2, C30.2, C31.2, D7.2 (A), D8.2 (A), R27.2, R29.2, U2.34 (GND), U2.41 (GND_PWR); also elsewhere on the board
GNDD: C12.2, C13.2, C15.2, R26.2, U2.17 (GND); also elsewhere on the board
unnamed: C17.1, D8.1 (K), L1.1, U2.28 (RSW)
unnamed: C17.2, U2.27 (RBST)
unnamed: C18.1, U2.19 (CPA)
unnamed: C18.2, U2.20 (CPB)
unnamed: C20.1, U2.22 (BSTA)
unnamed: C21.1, U2.37 (BSTB)
unnamed: C22.1, U2.2 (BSTC)
unnamed: R22.2, U2.35 (REN)
unnamed: R25.2, U2.15 (OCREF)
unnamed: R26.1, U2.16 (DT)
unnamed: R28.2, R29.1, U2.33 (RFB)

Notes on the sheet:
For overvotlage protection
Deadtime set by: t(ns) = 3.7*r(kOhms)
R = 0.5/I_limit = 0.5/20
HES are filtered in the MCU block

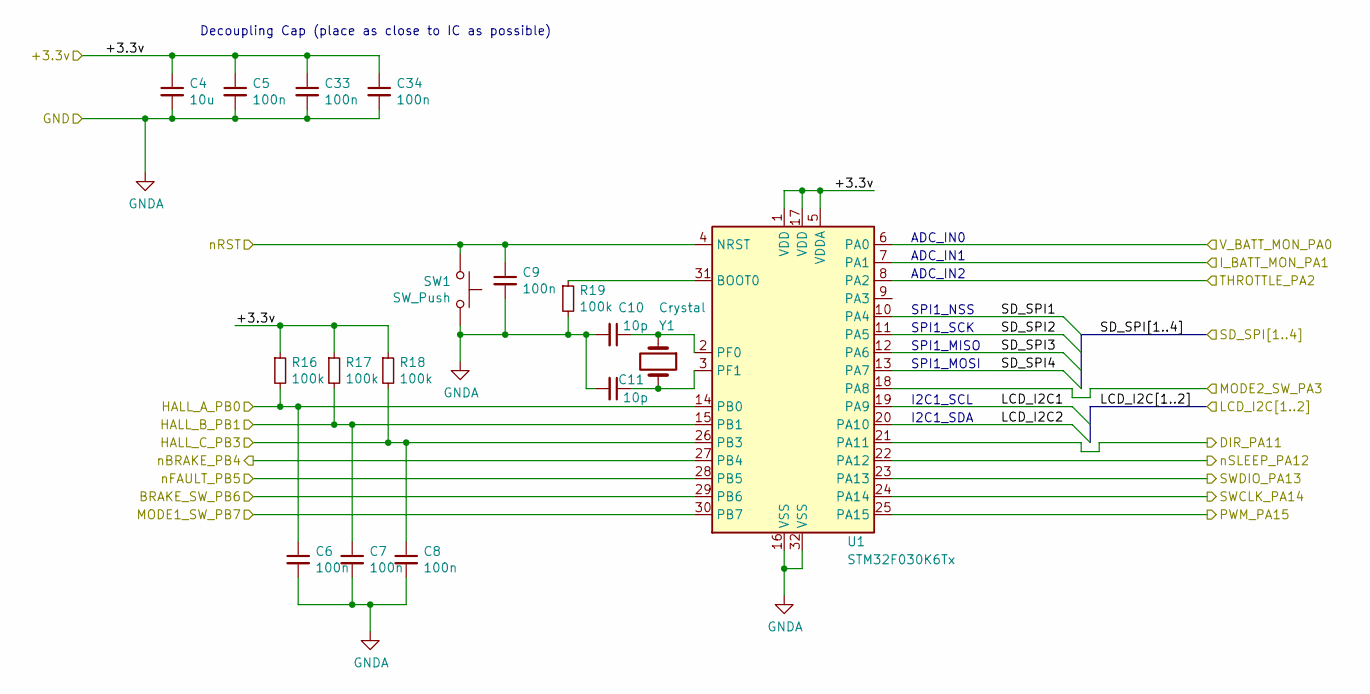
[picture p21: schematic MCU.sch]

Parts:
C4: 10u; C_0805_2012Metric_Pad1.15x1.40mm_HandSolder
C5, C6, C7, C8, C33, C34: 100n; C_0805_2012Metric_Pad1.15x1.40mm_HandSolder
C9: 100n; C_0805_2012Metric
C10, C11: 10p; C_0805_2012Metric
R16, R17, R18, R19: 100k; R_0805_2012Metric_Pad1.15x1.40mm_HandSolder
SW1: SW_Push; SW_Push_1P1T_NO_6x6mm_H9.5mm
U1: STM32F030K6Tx; LQFP-32_7x7mm_P0.8mm
Y1: Crystal; Crystal_SMD_HC49-SD

Connections:
/+3.3V: C4.1, C5.1, C33.1, C34.1, R16.1, R17.1, R18.1, U1.1 (VDD), U1.5 (VDDA), U1.17 (VDD); also elsewhere on the board
/BLDC Driver/DIR_PA1: U1.21 (PA11); also elsewhere on the board
/BLDC Driver/HA: C6.1, R16.2, U1.14 (PB0); also elsewhere on the board
/BLDC Driver/PWM_PA0: U1.25 (PA15); also elsewhere on the board
/BLDC Driver/nBRAKE_PA3: U1.27 (PB4); also elsewhere on the board
/BLDC Driver/nFAULT: U1.28 (PB5); also elsewhere on the board
/BMS/I_BATT_MON_PA1: U1.7 (PA1); also elsewhere on the board
/BMS/V_BATT_MON_PA0: U1.6 (PA0); also elsewhere on the board
/BRAKE_SW_BP6: U1.29 (PB6); also elsewhere on the board
/LCD/LCD_I2C1: U1.19 (PA9); also elsewhere on the board
/LCD/LCD_I2C2: U1.20 (PA10); also elsewhere on the board
/MCU/HALL_B_PB1: C7.1, R17.2, U1.15 (PB1); also elsewhere on the board
/MCU/HALL_C_PB3: C8.1, R18.2, U1.26 (PB3); also elsewhere on the board
/MCU/SD_SPI1: U1.10 (PA4); also elsewhere on the board
/MCU/SD_SPI2: U1.11 (PA5); also elsewhere on the board
/MCU/SD_SPI3: U1.12 (PA6); also elsewhere on the board
/MCU/SD_SPI4: U1.13 (PA7); also elsewhere on the board
/MCU/THROTTLE_PA2: U1.8 (PA2); also elsewhere on the board
/MCU/nSLEEP_PA12: U1.22 (PA12); also elsewhere on the board
/MODE1_SW_PB7: U1.30 (PB7); also elsewhere on the board
/MODE2_SW_PA3: U1.18 (PA8); also elsewhere on the board
/SWCLK: U1.24 (PA14); also elsewhere on the board
/SWDIO: U1.23 (PA13); also elsewhere on the board
/nRST: C9.1, SW1.1, U1.4 (NRST); also elsewhere on the board
GNDA: C4.2, C5.2, C6.2, C7.2, C8.2, C9.2, C10.2, C11.2, C33.2, C34.2, R19.2, SW1.2, U1.16 (VSS), U1.32 (VSS); also elsewhere on the board
unnamed: C10.1, U1.2 (PF0), Y1.1
unnamed: C11.1, U1.3 (PF1), Y1.2
unnamed: R19.1, U1.31 (BOOT0)

Notes on the sheet:
ADC_IN0
ADC_IN1
SPI1_MISO
SPI1_MOSI
I2C1_SCL
I2C1_SDA
SPI1_SCK
SPI1_NSS
Decoupling Cap (place as close to IC as possible)
ADC_IN2

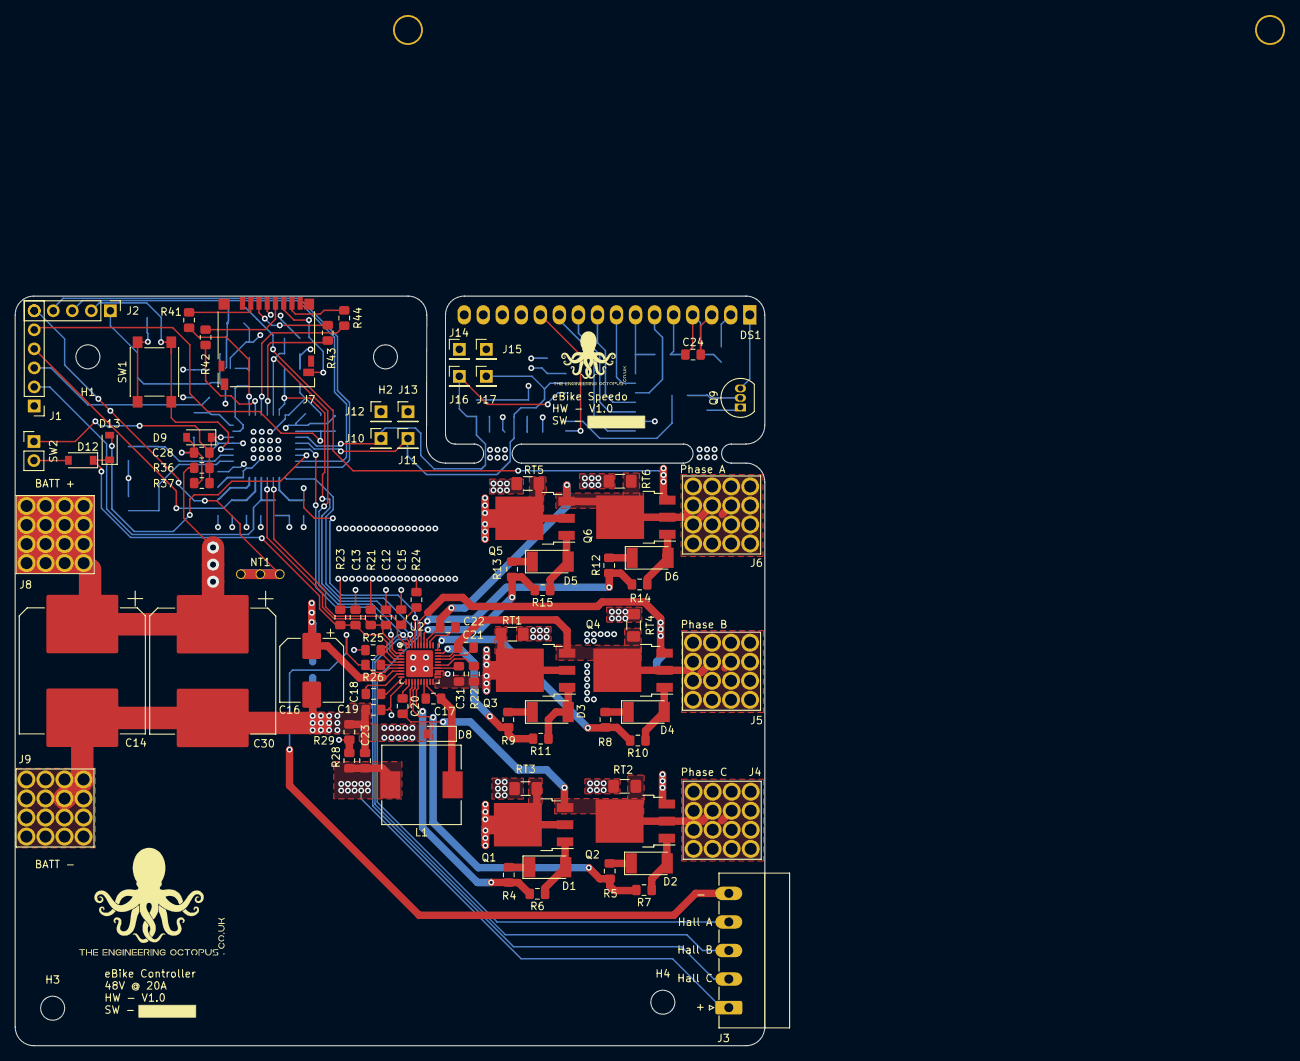
[picture p22: board Ebike_Controller.kicad_pcb from above]

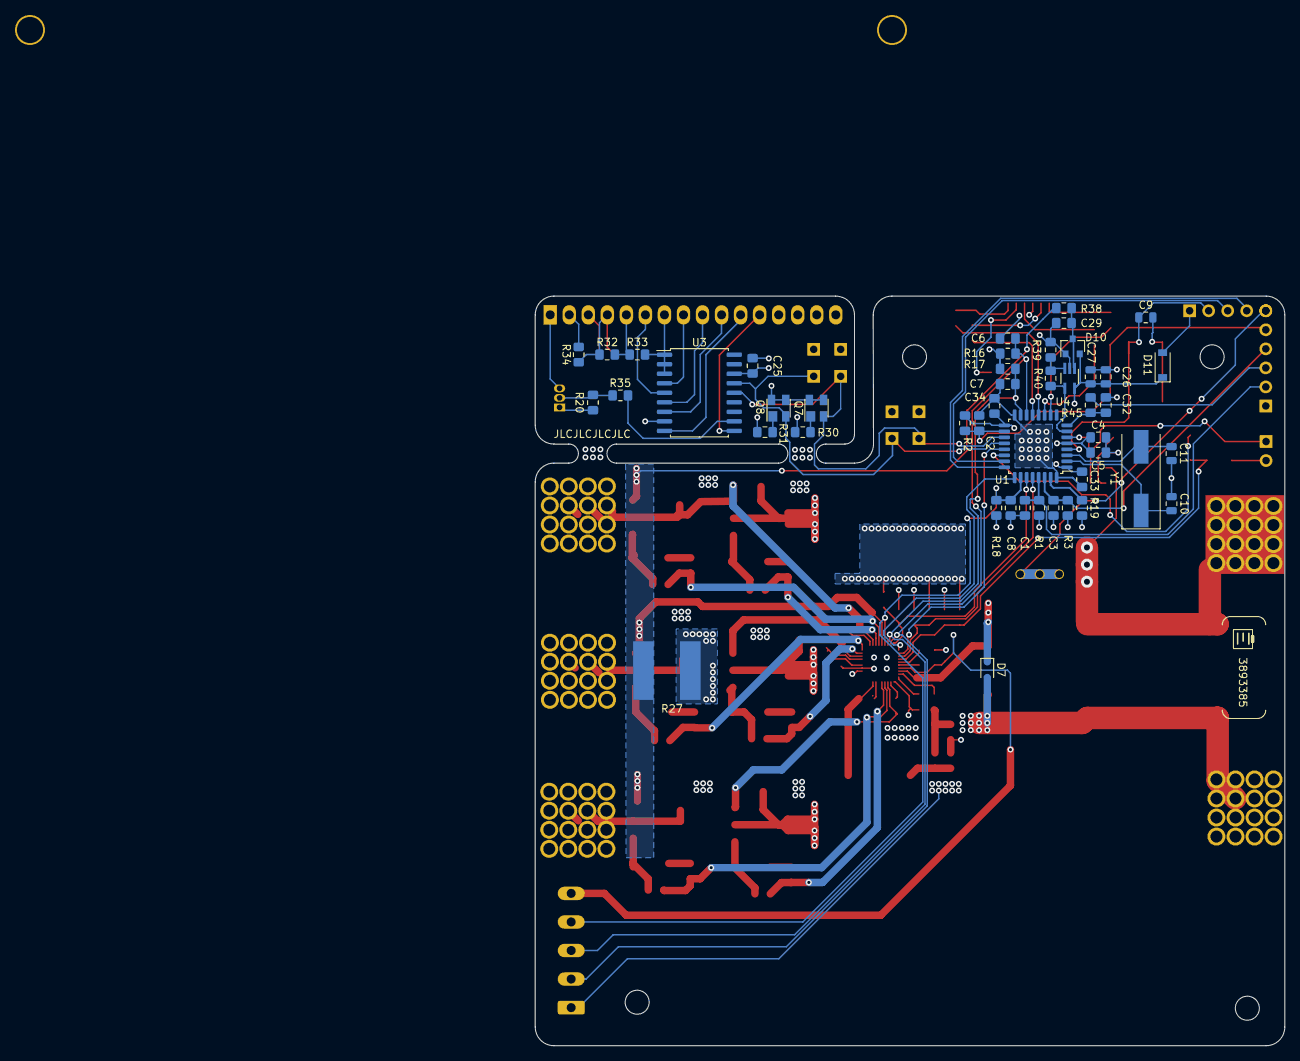
[picture p23: board Ebike_Controller.kicad_pcb from below]

Board: 4 copper layers, 100.0 x 100.0 mm, 138 parts (46 on the bottom side), 88 nets.
