maxsimmonds1337/EBIKE/(commit log)

2020-10-28 Started the schematic
    [BLDC Driver.sch, BMS.sch, Ebike_Controller.kicad_pcb, Ebike_Controller.sch, LCD.sch, MCU.sch, SD CARD.sch, Triple_H_Bridge.sch]
2020-11-03 close to being done, need to add current pull ups on i2c
    [BLDC Driver.sch, BMS.sch, Ebike_Controller.sch, LCD.sch, MCU.sch, SD CARD.sch]
2020-11-19 schem done
    [BLDC Driver.sch, BMS.sch, Ebike_Controller.sch, LCD.sch, MCU.sch, SD CARD.sch]
2020-11-24 adding footprints
    [BLDC Driver.sch, BMS.sch, Ebike_Controller.sch, LCD.sch, MCU.sch, SD CARD.sch, Triple_H_Bridge.sch]
2021-01-02 50% of the way through the layout
    [BLDC Driver.sch, BMS.sch, Download_STP_7461383_rev1.stp, Ebike_Controller.sch, LCD.sch, MCU.sch, SD CARD.sch, Triple_H_Bridge.sch]
2021-01-07 Layout done. will tidy up ref des next
    [BLDC Driver.sch, Ebike_Controller.kicad_pcb, Ebike_Controller.sch, LCD.sch, MCU.sch, SD CARD.sch]
2021-01-08 Finished ready for fab
    [BMS.sch, Ebike_Controller.kicad_pcb, Ebike_Controller.sch, Triple_H_Bridge.sch]
2021-01-10 done and gerbes sent to JLC
    [BLDC Driver.sch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]
2021-01-10 Added JLC serial number and my logo
    [Ebike_Controller.kicad_pcb]
2021-01-10 replotted the gerbers, sedning to JLC
    [Ebike_Controller-B_Cu.gbr, Ebike_Controller-B_Mask.gbr, Ebike_Controller-B_SilkS.gbr, Ebike_Controller-Edge_Cuts.gbr, Ebike_Controller-F_Cu.gbr, Ebike_Controller-F_Mask.gbr, Ebike_Controller-F_SilkS.gbr, Ebike_Controller-In1_Cu.gbr]
2021-01-10 saved gerbers as zip
    [Ebike_Controller-B_Cu.gbr, Ebike_Controller-B_Mask.gbr, Ebike_Controller-B_SilkS.gbr, Ebike_Controller-Edge_Cuts.gbr, Ebike_Controller-F_Cu.gbr, Ebike_Controller-F_Mask.gbr, Ebike_Controller-F_SilkS.gbr, Ebike_Controller-In1_Cu.gbr]
2021-01-11 added a bom, this is the last commit on this branch
    [Ebike_Controller.xls]
2021-09-16 updating the repo
    [Ebike_Controller.csv, Ebike_Controller.kicad_pcb, Ebike_Controller.xls, SpeedoHolder.SLDPRT, SpeedoHolder.STL, box.SLDPRT, box.STL, box2.SLDPRT]
